ashwin-prabhu/IoT-Urinometer-ESP32-RealTime-Monitoring/images/Custom Hardware.jpg

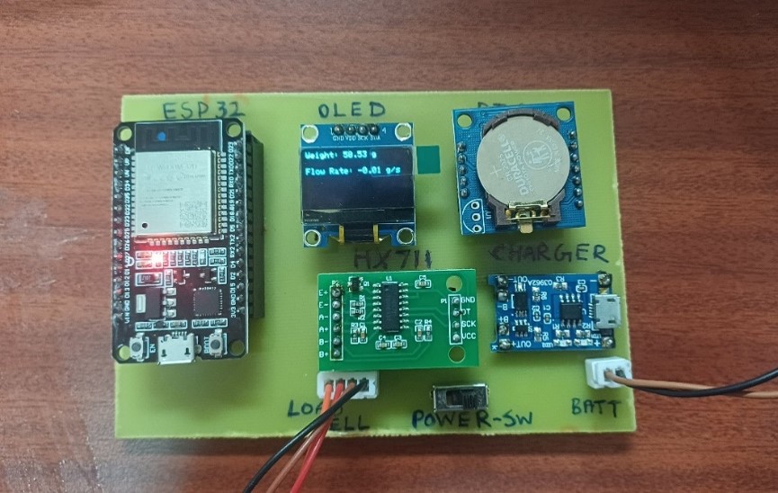
images/Custom Hardware.jpg
