ashwin-prabhu/IoT-Urinometer-ESP32-RealTime-Monitoring/images/Experimental setup.jpg

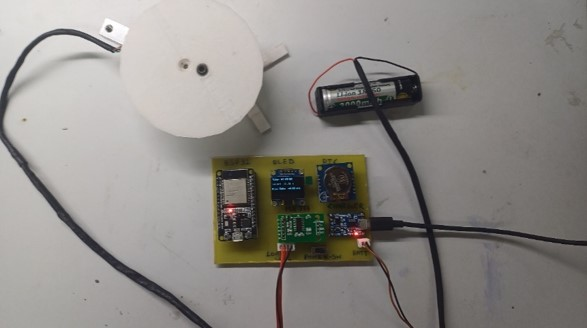
images/Experimental setup.jpg
