ashwin-prabhu/IoT-Urinometer-ESP32-RealTime-Monitoring/images/PCB layout.JPG

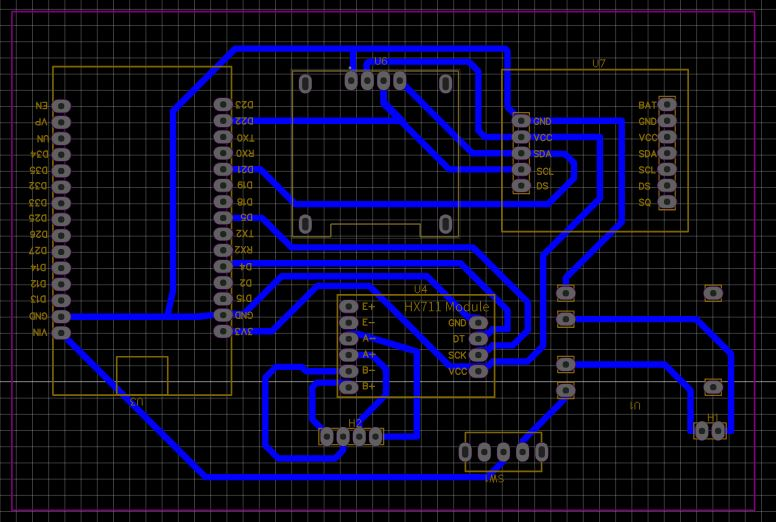
images/PCB layout.JPG
