ashwin-prabhu/IoT-Urinometer-ESP32-RealTime-Monitoring/images/Urinometer Dashboard.png

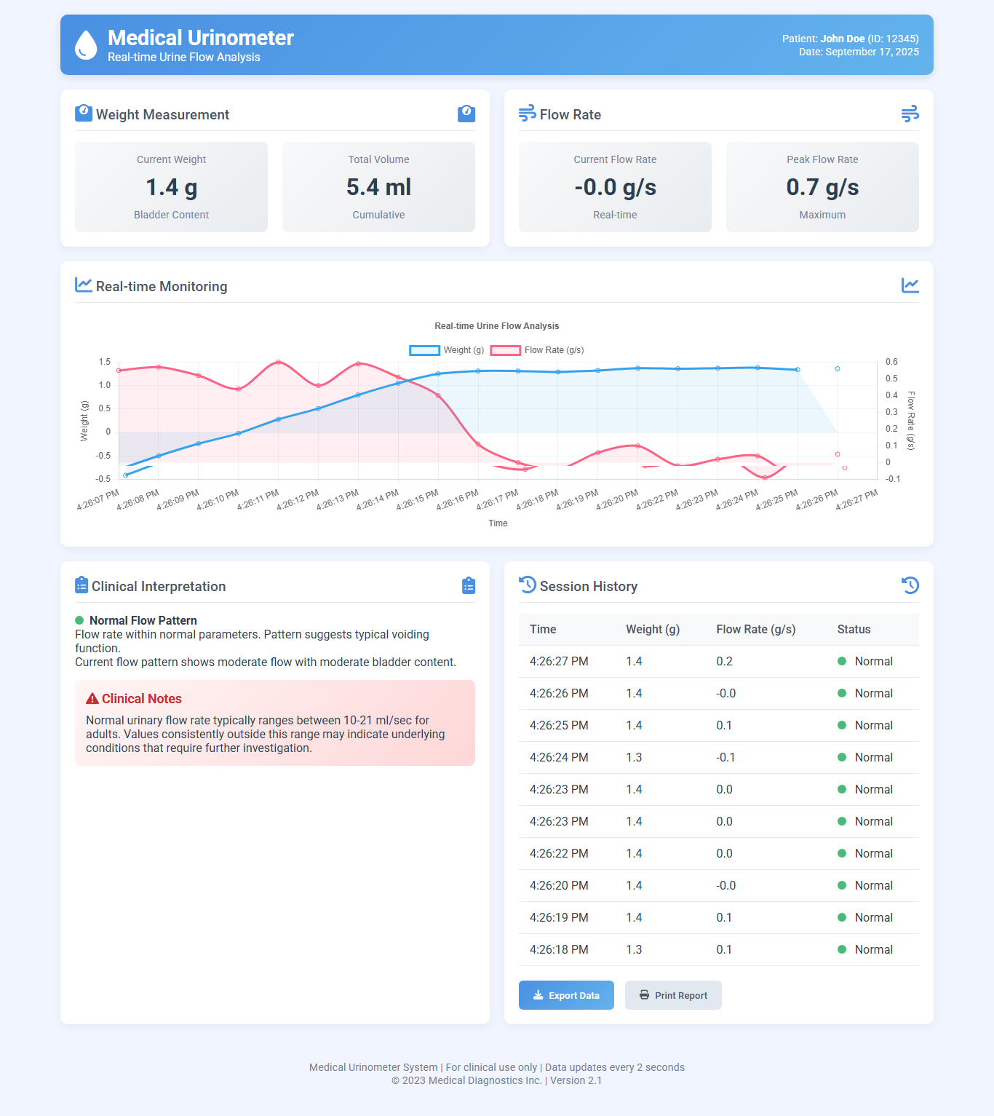
images/Urinometer Dashboard.png
