ashwin-prabhu/IoT-Urinometer-ESP32-RealTime-Monitoring/(list of files, drawings)

Other design files:
hardware/PCB_PCB_Urinometer.json
hardware/PCB_TP4056_chargerModule_Footprint_2026-04-10.json
hardware/SCH_Urinometer.json
